jimmyyhwu/tidybot2-resources/README.md

# tidybot2-resources

This repository hosts resources for the TidyBot++ open-source robot. Please see the following links for more information:

* Project page: https://tidybot2.github.io
* Assembly guide: https://tidybot2.github.io/docs
* Code: https://github.com/jimmyyhwu/tidybot2
