jimmyyhwu/tidybot2-resources/Machining/Intermediate Shaft - Specifications.pdf

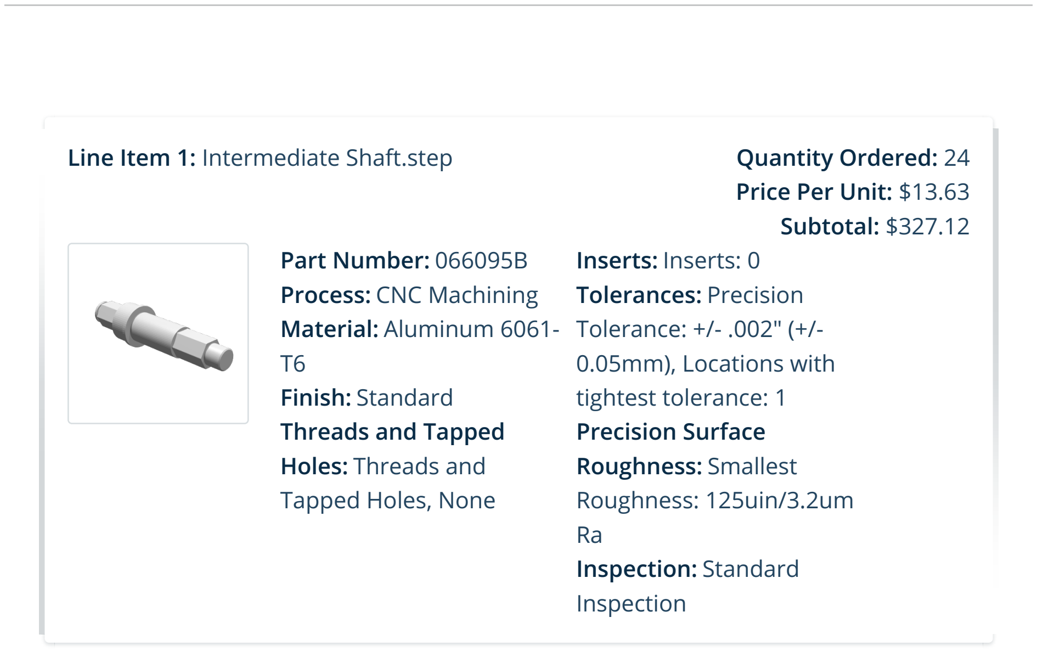
[picture p1: page 1]

Line Item 1: Intermediate Shaft.step | Quantity Ordered: 24 Price Per Unit: $13.63 Subtotal: $327.12
Part Number: 066095B Process: CNC Machining Material: Aluminum 6061- T6 Finish: Standard Threads and Tapped Holes: Threads and Tapped Holes, None | Inserts: Inserts: 0 Tolerances: Precision Tolerance: +/- .002" (+/- 0.05mm), Locations with tightest tolerance: 1 Precision Surface Roughness: Smallest Roughness: 125uin/3.2um

Ra
| Inspection: Standard
Inspection
