jimmyyhwu/tidybot2-resources/3D Printing/ARX5/ARX5 Wrist Camera Mount Bottom.stl

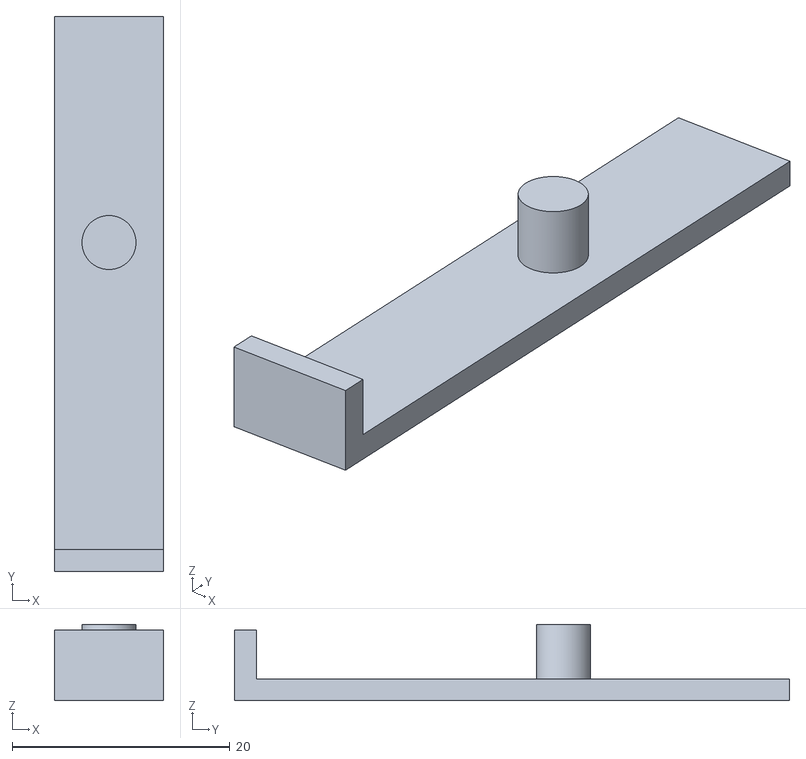
[picture p2: CAD file, 2024-12-10]
3D Printing/ARX5/ARX5 Wrist Camera Mount Bottom.stl
10.0 x 51.0 x 7.00
