jimmyyhwu/tidybot2-resources/3D Printing/Caster Module Alignment Jig.stl

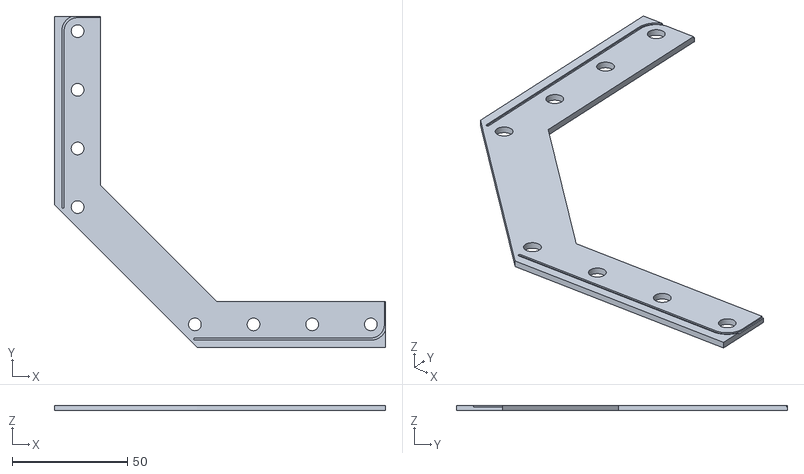
[picture p3: CAD file, 2024-12-10]
3D Printing/Caster Module Alignment Jig.stl
143.3 x 143.3 x 2.00
