jimmyyhwu/tidybot2-resources/3D Printing/Caster Module/Bambu Lab X1-Carbon/Wheel Mount B.3mf

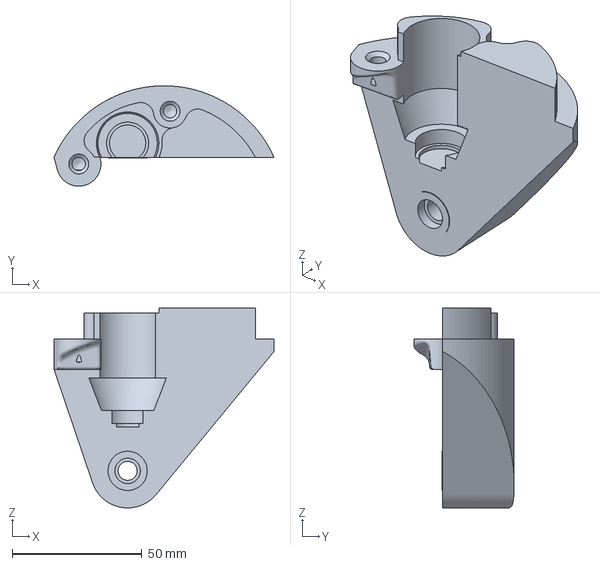
[picture p4: CAD file, 2024-12-10]
3D Printing/Caster Module/Bambu Lab X1-Carbon/Wheel Mount B.3mf
84.8 x 38.6 x 77.0 mm
