jimmyyhwu/tidybot2-resources/3D Printing/Caster Module/Bambu Lab X1E/Wheel Mount A.3mf

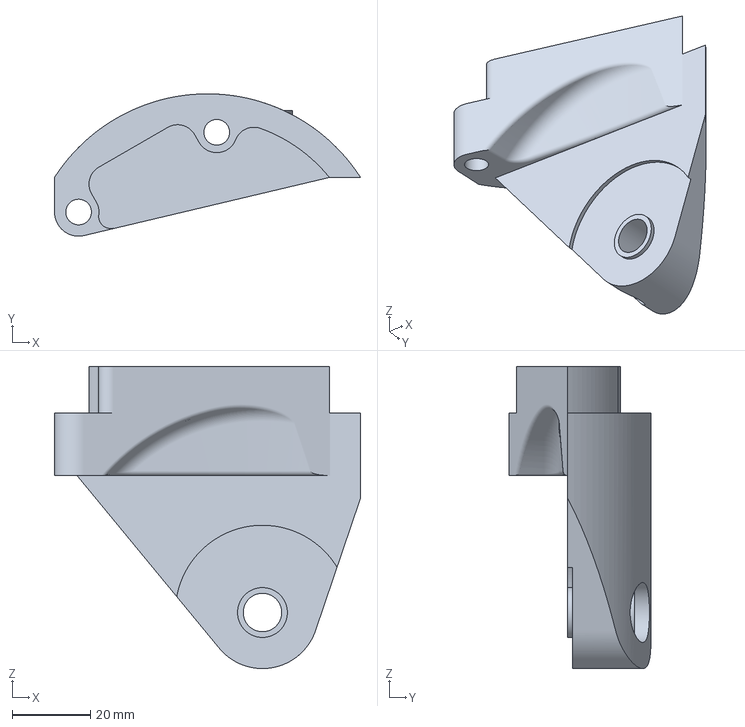
[picture p5: CAD file, 2024-12-10]
3D Printing/Caster Module/Bambu Lab X1E/Wheel Mount A.3mf
78.0 x 36.3 x 77.0 mm
