jimmyyhwu/tidybot2-resources/3D Printing/Franka/Franka Battery Mount Right.stl

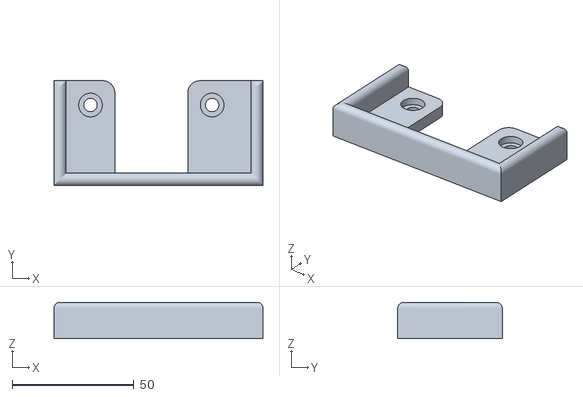
[picture p6: CAD file, 2024-12-10]
3D Printing/Franka/Franka Battery Mount Right.stl
85.9 x 43.0 x 15.0
