jimmyyhwu/tidybot2-resources/3D Printing/Kinova/Kinova Base Camera Mount Top.stl

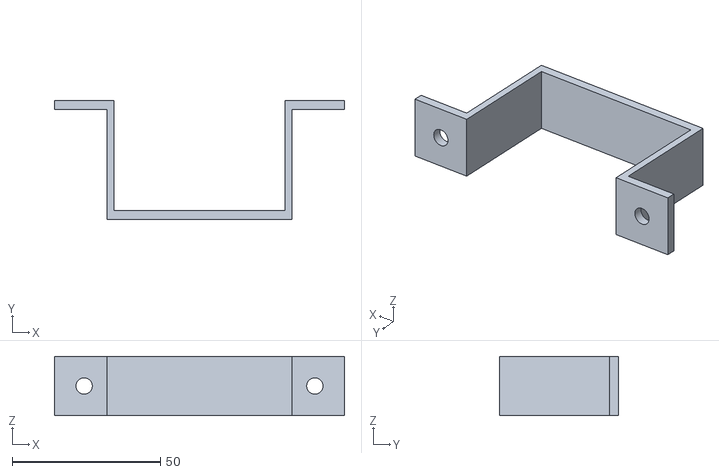
[picture p7: CAD file, 2024-12-10]
3D Printing/Kinova/Kinova Base Camera Mount Top.stl
97.8 x 40.0 x 20.0
