jimmyyhwu/tidybot2-resources/Laser Cutting/Kinova Bottom Plate.dxf

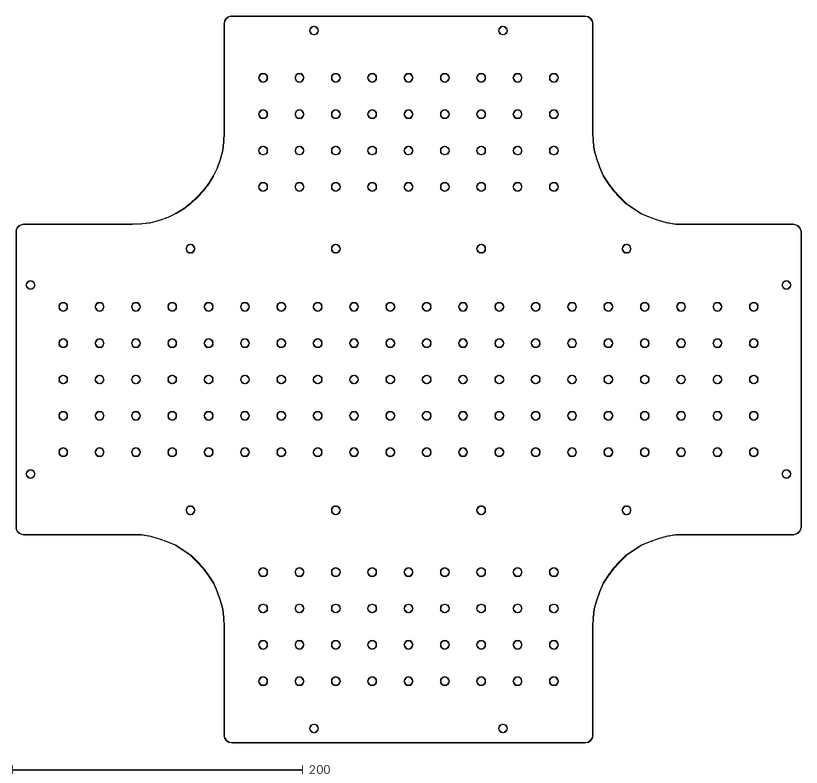
[picture p8: CAD file, 2024-12-10]
Laser Cutting/Kinova Bottom Plate.dxf
540.0 x 500.0
