jimmyyhwu/tidybot2-resources/STEP/Caster Module/Imports/WCP-1464.step

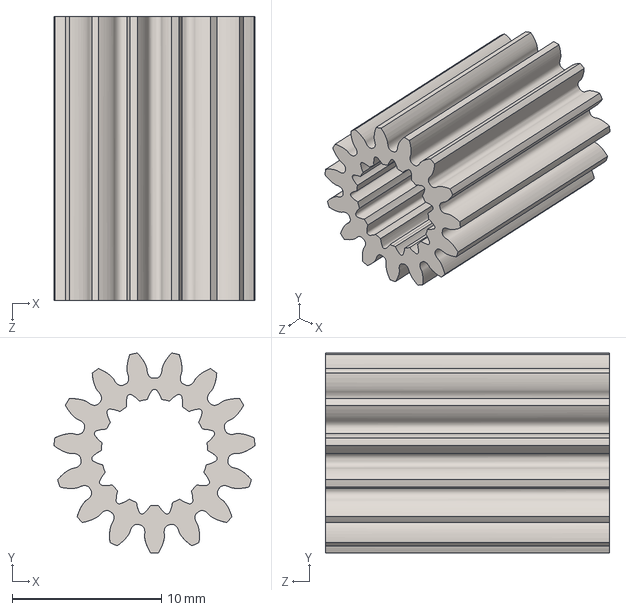
[picture p9: CAD file, 2024-12-10]
STEP/Caster Module/Imports/WCP-1464.step
13.5 x 13.4 x 19.1 mm
