jimmyyhwu/tidybot2-resources/STEP/Caster Module/Intermediate Shaft.step

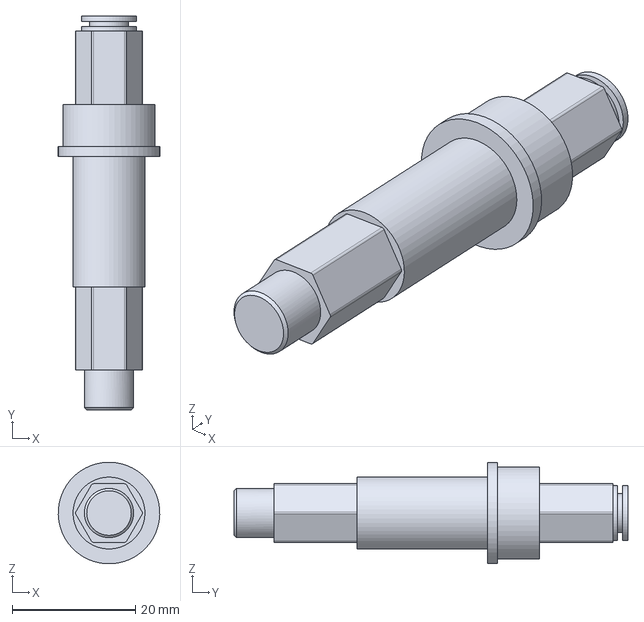
[picture p10: CAD file, 2024-12-10]
STEP/Caster Module/Intermediate Shaft.step
16.5 x 64.0 x 16.5 mm
