jimmyyhwu/tidybot2-resources/STEP/Mobile Base - ARX5.step

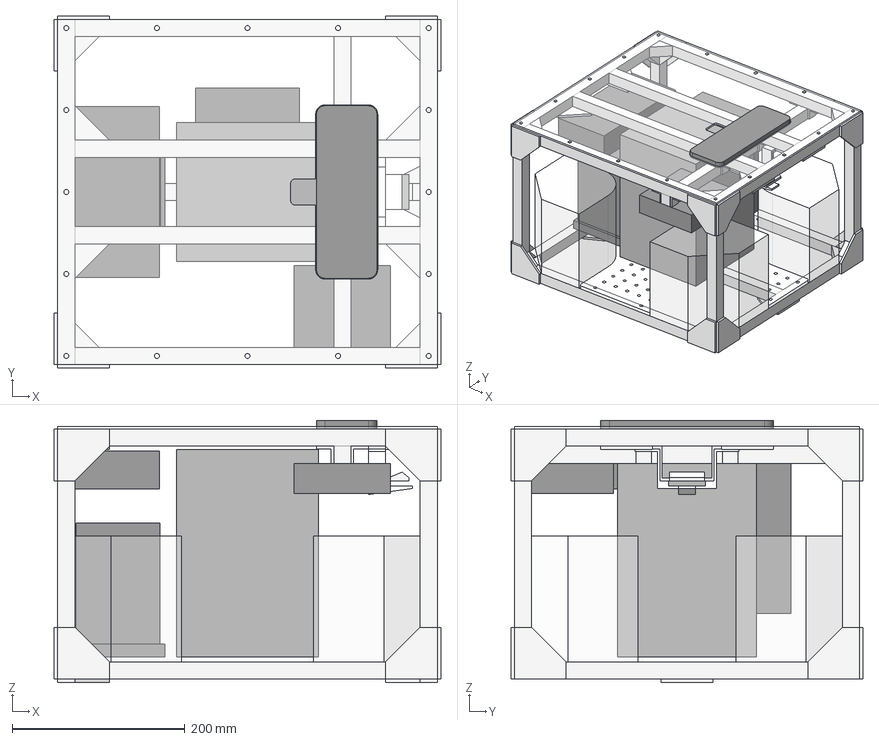
[picture p11: CAD file, 2024-12-10]
STEP/Mobile Base - ARX5.step
448.0 x 408.0 x 304.0 mm
2020 28mm Gusset x 16
ARX5 Bottom Plate
ARX5 Battery Mount
2020 20mm Corner Bracket x 8
Intel NUC7i5BNK
ARX5 Base Camera Mount Bottom
2020 90 Degree Plate x 20
2020 Tee Plate x 2
2020 250mm Rail x 4
2020 400mm Rail x 12
2020 20mm Gusset x 8
ARX5 Power Adapter
ARX5 Mounting Plate
Caster Module x 4
ARX5 Base Camera Mount Top
Duracell Ultra DURDC12-14NB Battery
Power Distribution Panel
Base Camera Mount Shim
ARX5 Top Plate
Anker SOLIX C300 Portable Power Station
