jimmyyhwu/tidybot2-resources/3D Printing/ARX5/ARX5 Base Camera Mount Bottom.stl

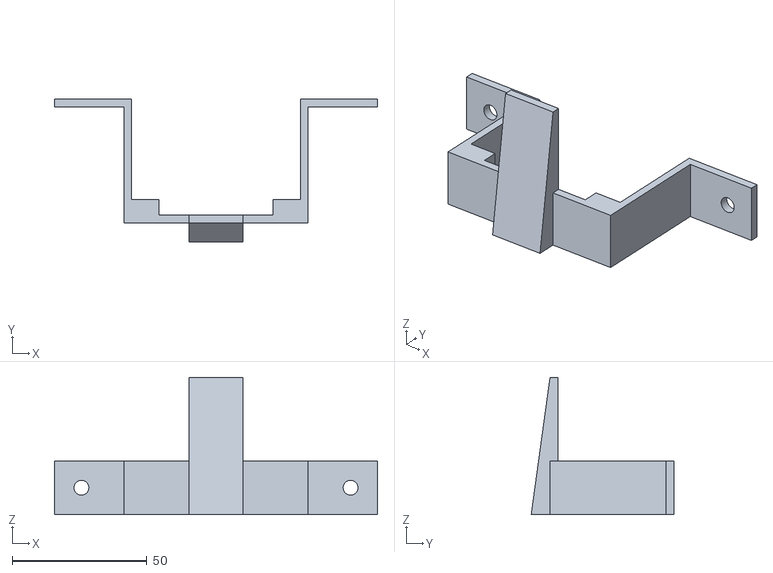
[picture p12: CAD file, 2024-12-10]
3D Printing/ARX5/ARX5 Base Camera Mount Bottom.stl
120.0 x 53.0 x 51.0
