jimmyyhwu/tidybot2-resources/3D Printing/Battery Flag.stl

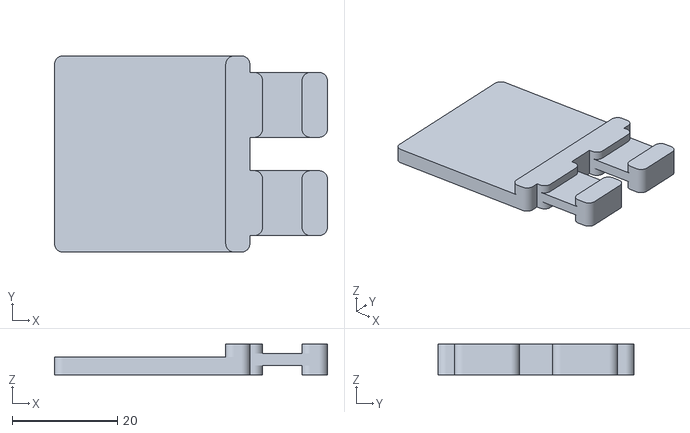
[picture p13: CAD file, 2024-12-10]
3D Printing/Battery Flag.stl
52.0 x 37.3 x 5.90
