jimmyyhwu/tidybot2-resources/3D Printing/Franka/Franka Base Camera Mount Bottom.stl

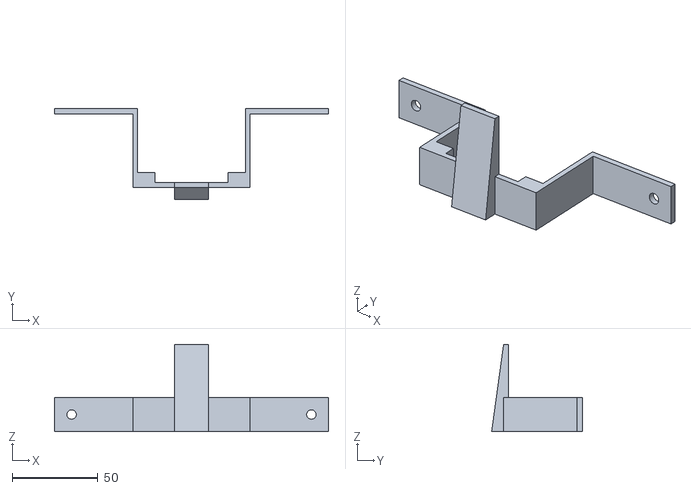
[picture p14: CAD file, 2024-12-10]
3D Printing/Franka/Franka Base Camera Mount Bottom.stl
160.0 x 53.0 x 51.0
