jimmyyhwu/tidybot2-resources/3D Printing/Kinova/Kinova Base Camera Mount Bottom.stl

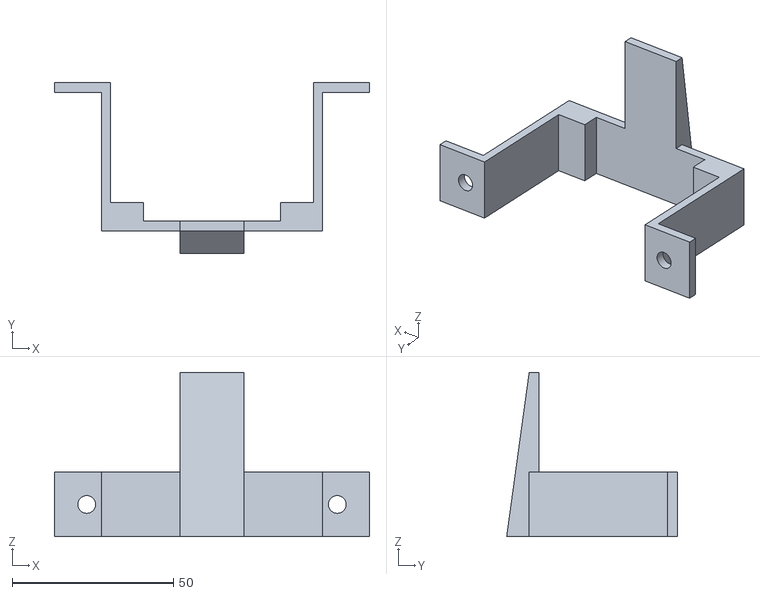
[picture p15: CAD file, 2024-12-10]
3D Printing/Kinova/Kinova Base Camera Mount Bottom.stl
97.8 x 53.0 x 51.0
