jimmyyhwu/tidybot2-resources/Laser Cutting/Franka Bottom Plate Back.dxf

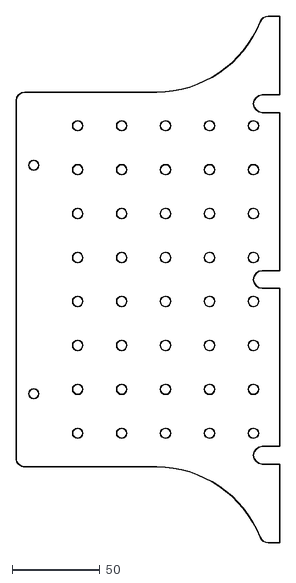
[picture p16: CAD file, 2024-12-10]
Laser Cutting/Franka Bottom Plate Back.dxf
150.0 x 299.6
