jimmyyhwu/tidybot2-resources/STEP/Caster Module/Imports/Kraken X60 Motor Riser.step

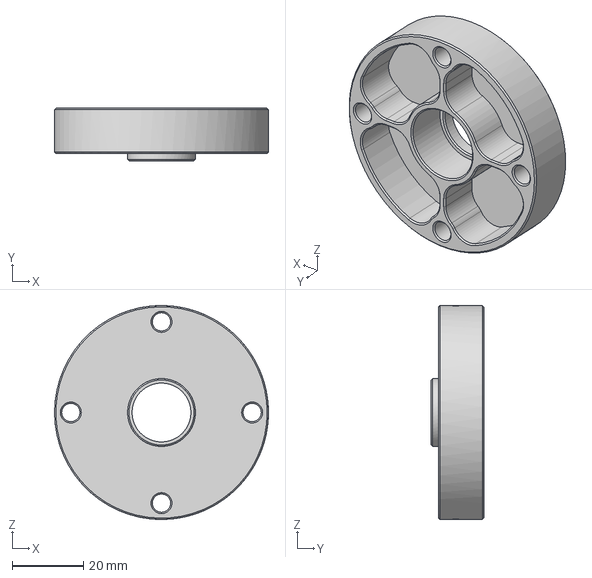
[picture p17: CAD file, 2024-12-10]
STEP/Caster Module/Imports/Kraken X60 Motor Riser.step
59.9 x 14.7 x 59.9 mm
