jimmyyhwu/tidybot2-resources/STEP/Logitech Wrist Camera Mount Bottom.step

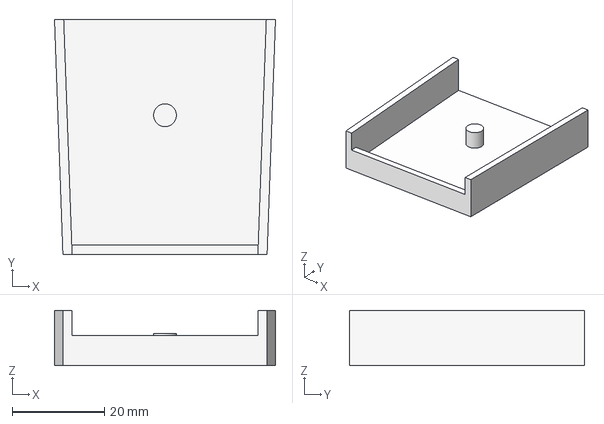
[picture p18: CAD file, 2024-12-10]
STEP/Logitech Wrist Camera Mount Bottom.step
48.0 x 51.0 x 12.0 mm
