jimmyyhwu/tidybot2-resources/3D Printing/ARX5/ARX5 Wrist Camera Mount Top.stl

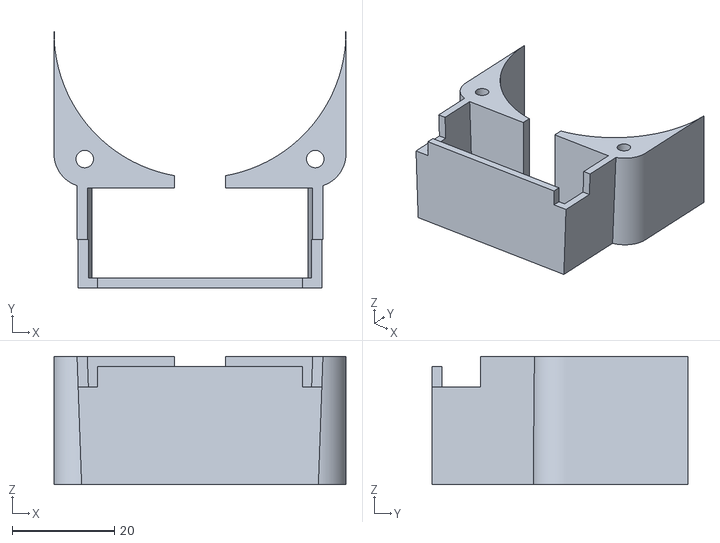
[picture p19: CAD file, 2024-12-10]
3D Printing/ARX5/ARX5 Wrist Camera Mount Top.stl
57.0 x 50.0 x 25.0
