jimmyyhwu/tidybot2-resources/3D Printing/Base Camera Mount Shim.stl

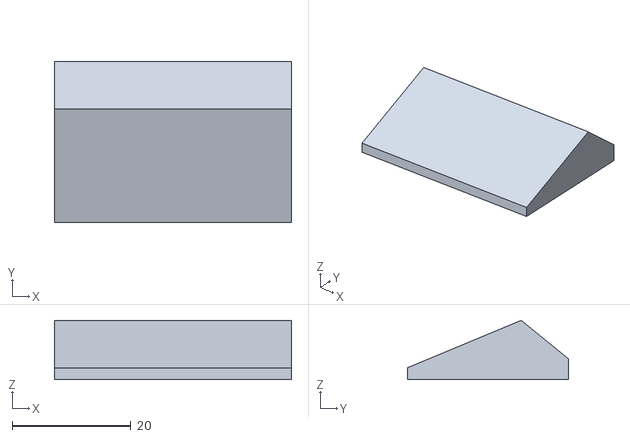
[picture p20: CAD file, 2024-12-10]
3D Printing/Base Camera Mount Shim.stl
40.0 x 27.2 x 10.0
