jimmyyhwu/tidybot2-resources/3D Printing/Franka/Franka Bottom Plate Support Bracket.stl

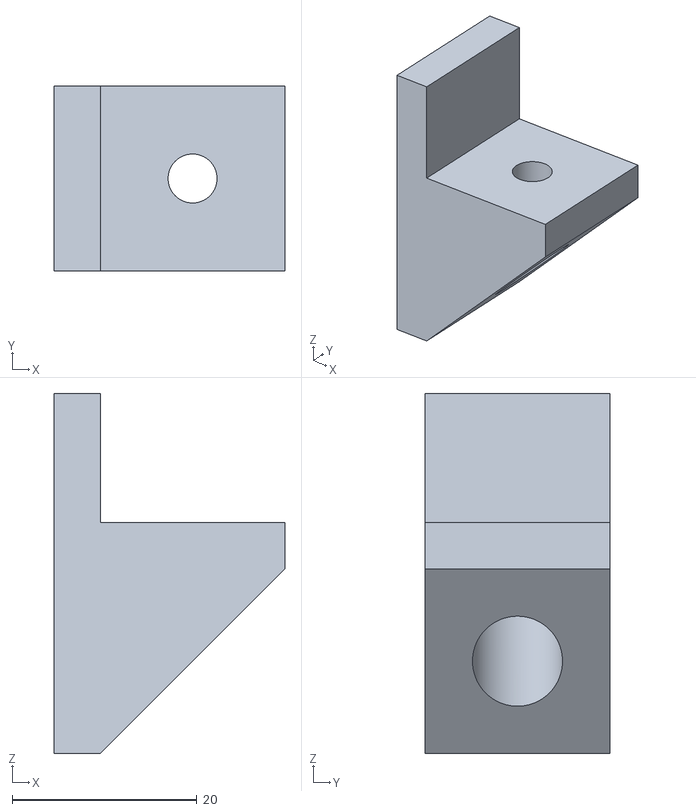
[picture p21: CAD file, 2024-12-10]
3D Printing/Franka/Franka Bottom Plate Support Bracket.stl
25.0 x 20.0 x 39.0
