jimmyyhwu/tidybot2-resources/Laser Cutting/Kinova Top Plate Right.dxf

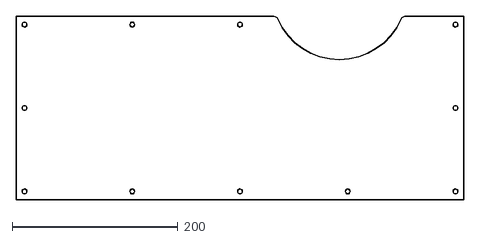
[picture p22: CAD file, 2024-12-10]
Laser Cutting/Kinova Top Plate Right.dxf
540.0 x 221.1
