jimmyyhwu/tidybot2-resources/STEP/Caster Module/Imports/SDS Colson Wheel Kit.STEP

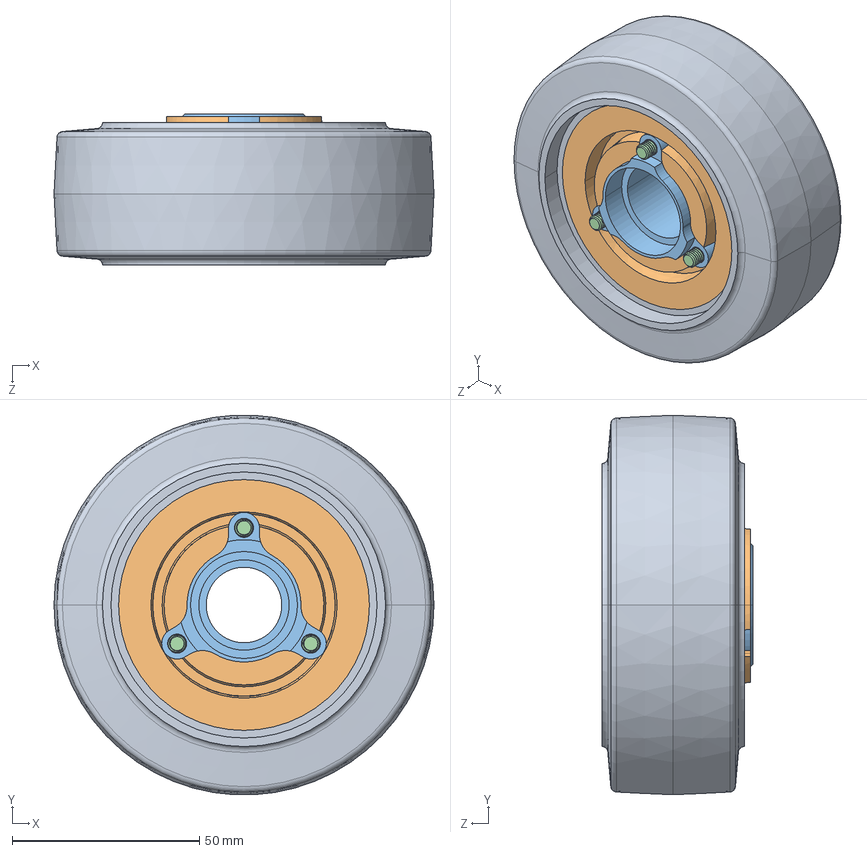
[picture p23: CAD file, 2024-12-10]
STEP/Caster Module/Imports/SDS Colson Wheel Kit.STEP
101.6 x 101.5 x 40.4 mm
Colson Performa 4 X 1.5
MK4 Colson Hub 4 X 1.5
Screw, 10-32 X 1, 91251A347_91251A347 x 3
