jimmyyhwu/tidybot2-resources/3D Printing/ARX5/ARX5 Battery Mount.stl

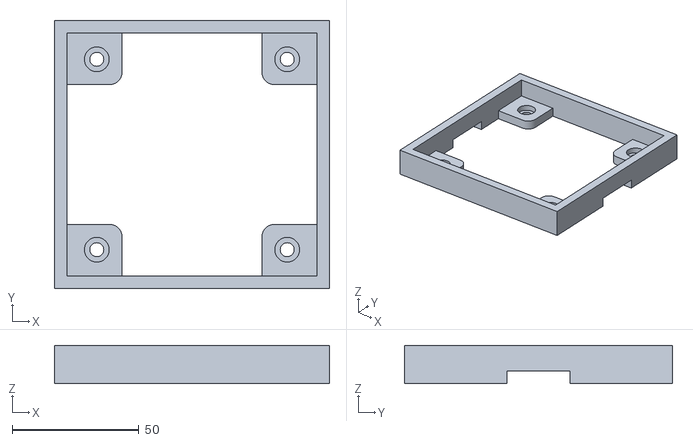
[picture p25: CAD file, 2024-12-10]
3D Printing/ARX5/ARX5 Battery Mount.stl
108.3 x 105.7 x 15.0
