jimmyyhwu/tidybot2-resources/3D Printing/Franka/Franka Wrist Camera Mount.stl

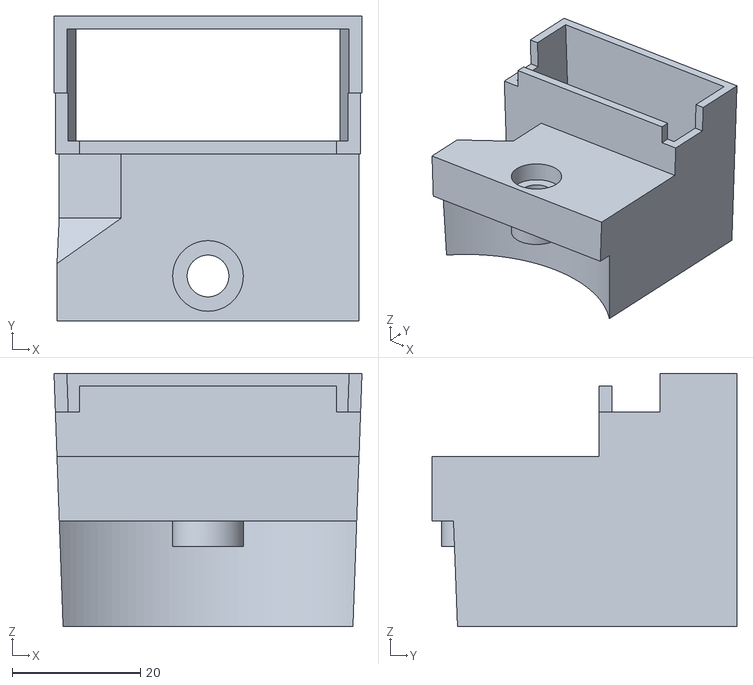
[picture p26: CAD file, 2024-12-10]
3D Printing/Franka/Franka Wrist Camera Mount.stl
48.0 x 47.5 x 39.5
