jimmyyhwu/tidybot2-resources/3D Printing/Kinova/Kinova Mounting Plate Alignment Jig.stl

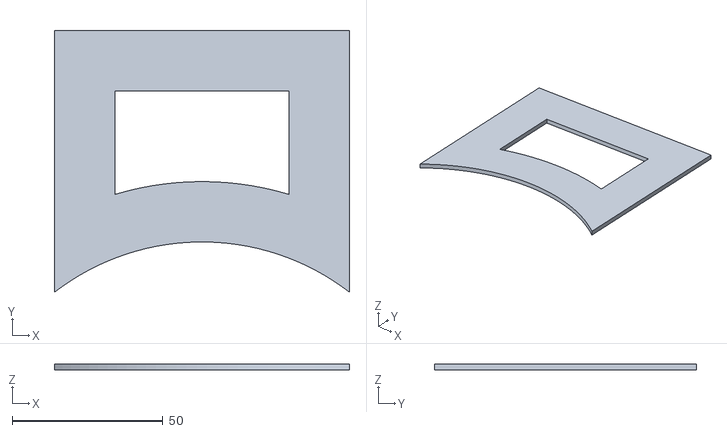
[picture p27: CAD file, 2024-12-10]
3D Printing/Kinova/Kinova Mounting Plate Alignment Jig.stl
97.8 x 86.7 x 2.00
