jimmyyhwu/tidybot2-resources/3D Printing/Wheel Alignment Jig.stl

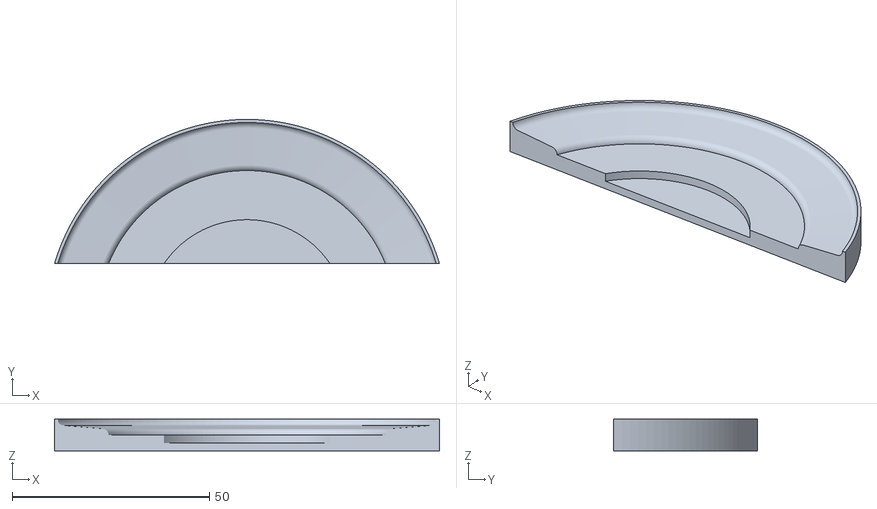
[picture p28: CAD file, 2024-12-10]
3D Printing/Wheel Alignment Jig.stl
97.5 x 36.5 x 8.00
