jimmyyhwu/tidybot2-resources/Laser Cutting/Kinova Top Plate Left.dxf

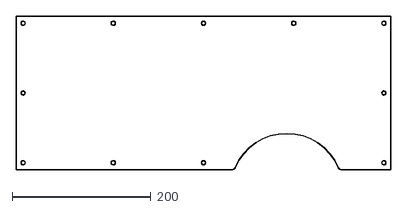
[picture p29: CAD file, 2024-12-10]
Laser Cutting/Kinova Top Plate Left.dxf
540.0 x 221.1
