jimmyyhwu/tidybot2-resources/STEP/Caster Module/Imports/WCP-1013.step

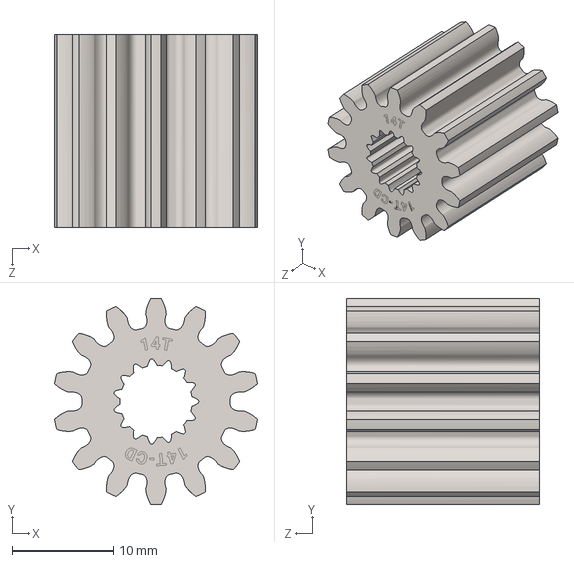
[picture p30: CAD file, 2024-12-10]
STEP/Caster Module/Imports/WCP-1013.step
20.0 x 20.3 x 19.1 mm
