jimmyyhwu/tidybot2-resources/STEP/Logitech Wrist Camera Mount Top.step

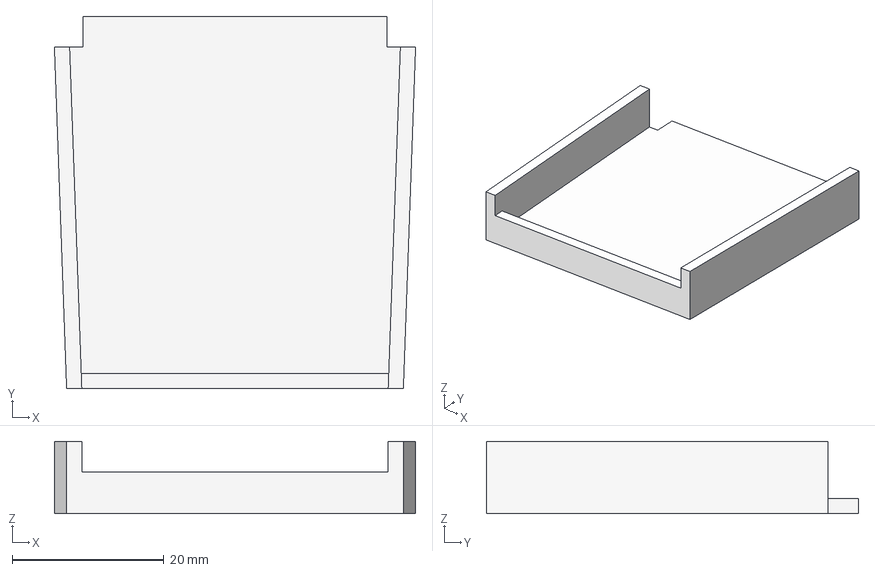
[picture p31: CAD file, 2024-12-10]
STEP/Logitech Wrist Camera Mount Top.step
47.6 x 49.0 x 9.50 mm
