jimmyyhwu/tidybot2-resources/3D Printing/ARX5/ARX5 Riser.stl

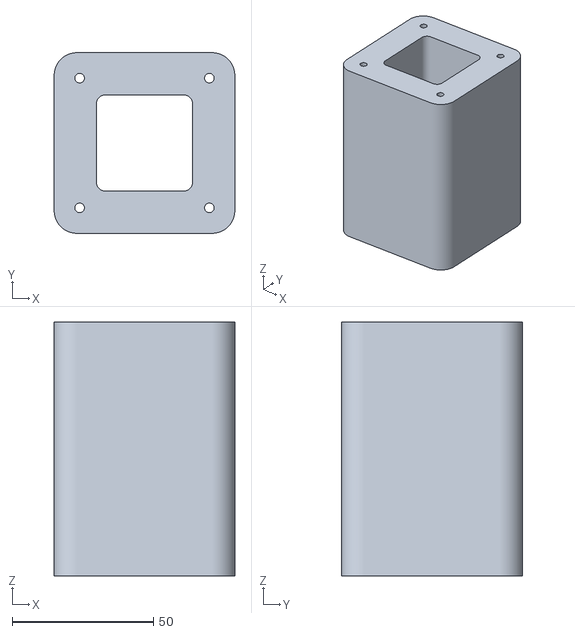
[picture p32: CAD file, 2024-12-10]
3D Printing/ARX5/ARX5 Riser.stl
64.0 x 64.0 x 90.0
