jimmyyhwu/tidybot2-resources/3D Printing/Breaker Terminal Spacer.stl

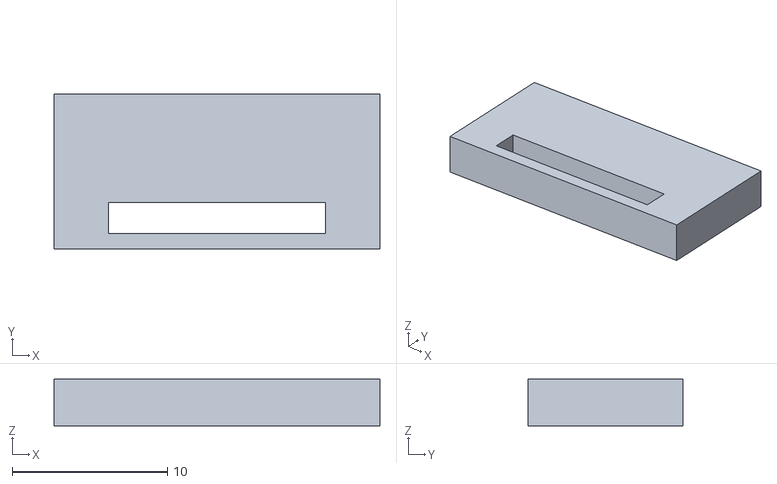
[picture p33: CAD file, 2024-12-10]
3D Printing/Breaker Terminal Spacer.stl
21.0 x 10.0 x 3.00
