jimmyyhwu/tidybot2-resources/3D Printing/Franka/Franka Base Camera Mount Top.stl

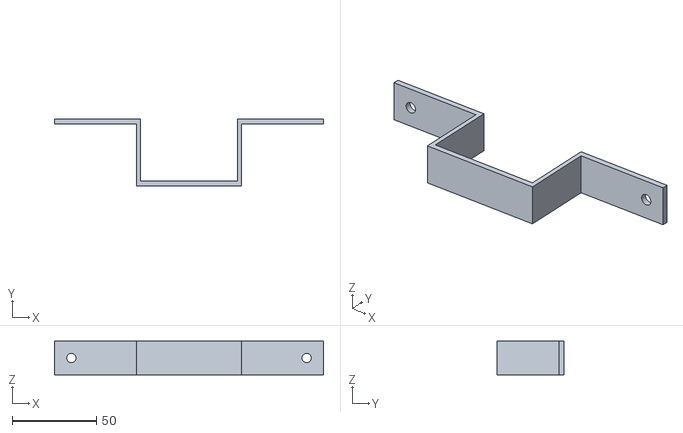
[picture p34: CAD file, 2024-12-10]
3D Printing/Franka/Franka Base Camera Mount Top.stl
160.0 x 40.0 x 20.0
