jimmyyhwu/tidybot2-resources/3D Printing/Kinova/Kinova Battery Mount Right.stl

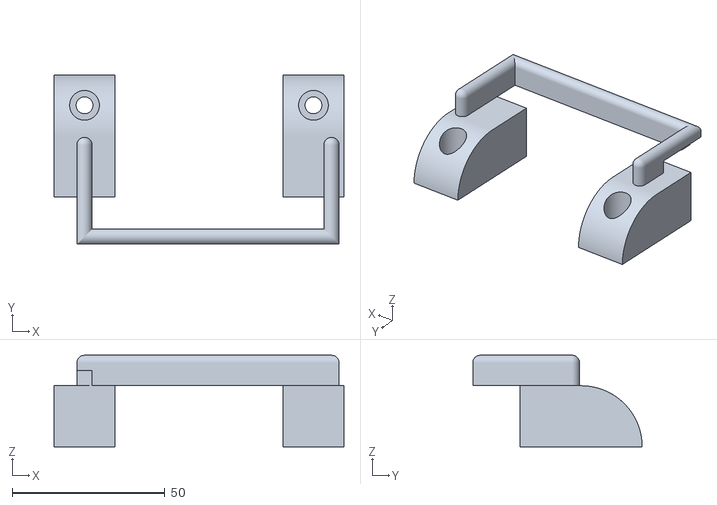
[picture p35: CAD file, 2024-12-10]
3D Printing/Kinova/Kinova Battery Mount Right.stl
95.0 x 55.5 x 30.0
