jimmyyhwu/tidybot2-resources/Laser Cutting/ARX5 Bottom Plate.dxf

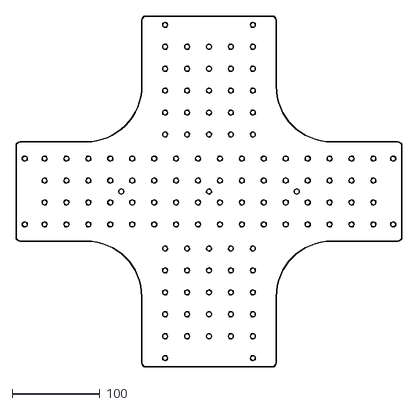
[picture p36: CAD file, 2024-12-10]
Laser Cutting/ARX5 Bottom Plate.dxf
440.0 x 400.0
