jimmyyhwu/tidybot2-resources/3D Printing/ARX5/ARX5 Base Camera Mount Top.stl

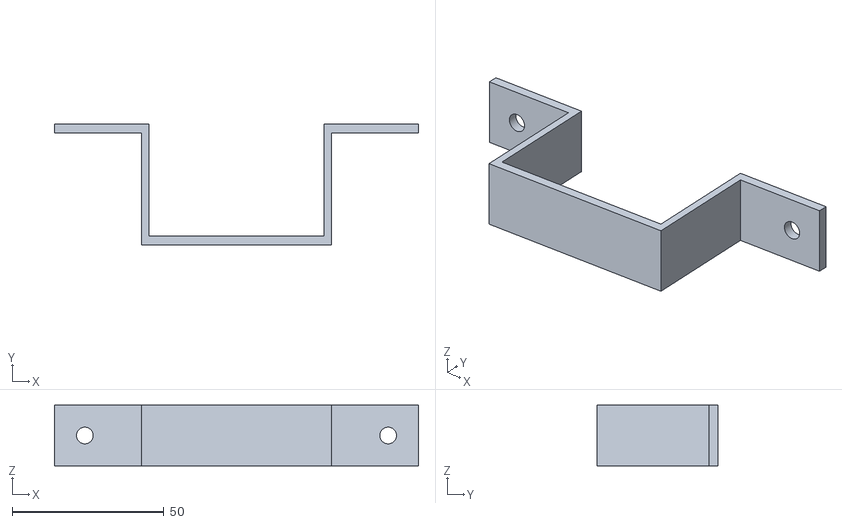
[picture p38: CAD file, 2024-12-10]
3D Printing/ARX5/ARX5 Base Camera Mount Top.stl
120.0 x 40.0 x 20.0
