jimmyyhwu/tidybot2-resources/3D Printing/Kinova/Kinova Fisheye Mount.stl

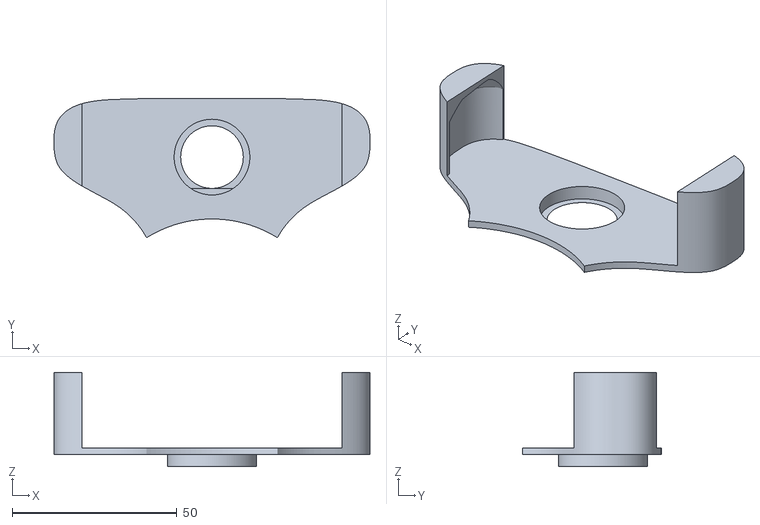
[picture p39: CAD file, 2024-12-10]
3D Printing/Kinova/Kinova Fisheye Mount.stl
96.0 x 42.4 x 28.6
