jimmyyhwu/tidybot2-resources/3D Printing/Logitech Fisheye Mount.stl

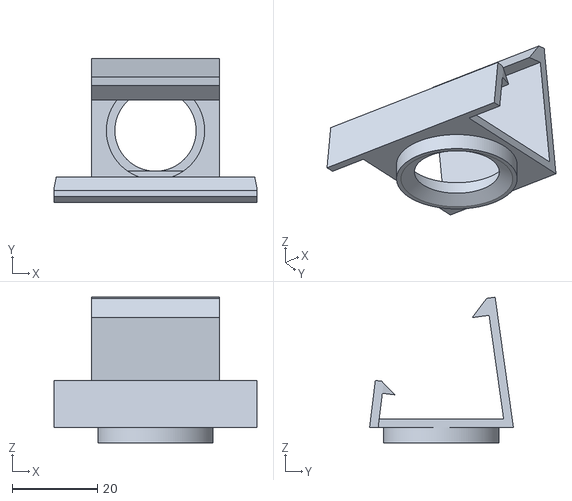
[picture p40: CAD file, 2024-12-10]
3D Printing/Logitech Fisheye Mount.stl
47.5 x 33.7 x 34.1
