jimmyyhwu/tidybot2-resources/Laser Cutting/Kinova Bottom Plate Back.dxf

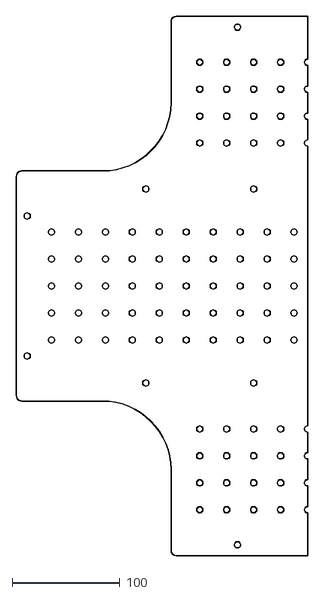
[picture p41: CAD file, 2024-12-10]
Laser Cutting/Kinova Bottom Plate Back.dxf
270.0 x 500.0
