jimmyyhwu/tidybot2-resources/STEP/Fisheye Mount.step

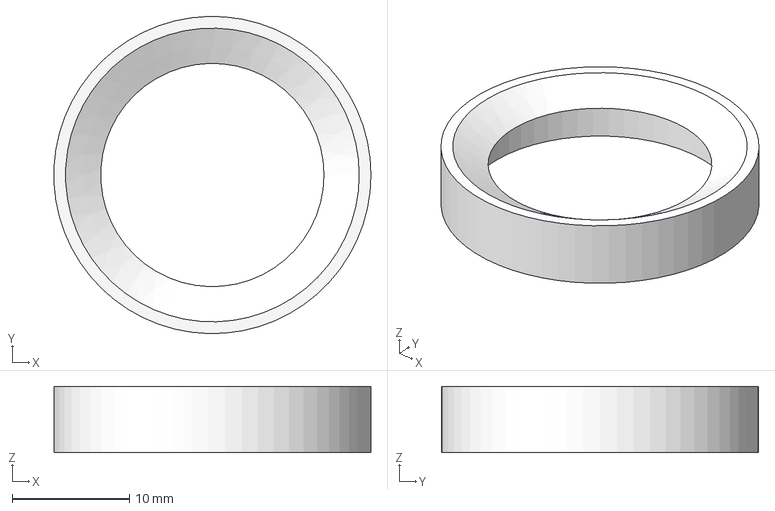
[picture p42: CAD file, 2024-12-10]
STEP/Fisheye Mount.step
27.0 x 27.0 x 5.63 mm
