jimmyyhwu/tidybot2-resources/Laser Cutting/Franka Bottom Plate Front (EcoFlow DELTA 2 Max).dxf

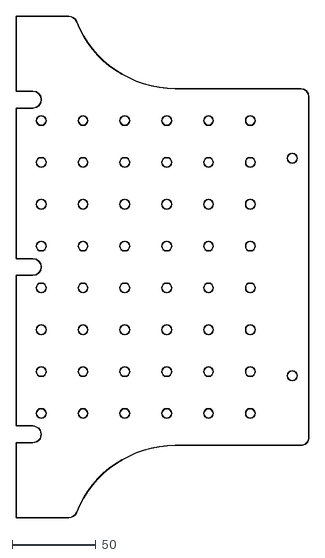
[picture p43: CAD file, 2024-12-10]
Laser Cutting/Franka Bottom Plate Front (EcoFlow DELTA 2 Max).dxf
175.0 x 299.6
