jimmyyhwu/tidybot2-resources/Laser Cutting/Franka Top Plate Front.dxf

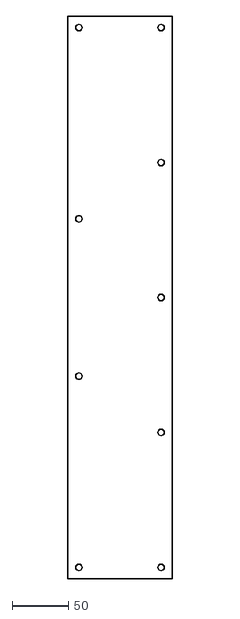
[picture p45: CAD file, 2024-12-10]
Laser Cutting/Franka Top Plate Front.dxf
93.0 x 500.0
