jimmyyhwu/tidybot2-resources/Laser Cutting/Kinova Bottom Plate Front.dxf

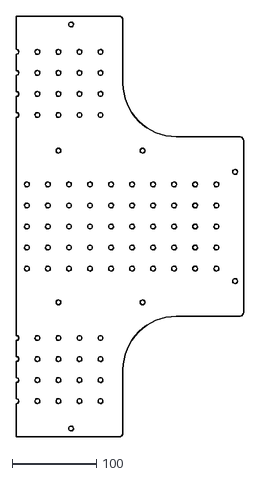
[picture p46: CAD file, 2024-12-10]
Laser Cutting/Kinova Bottom Plate Front.dxf
270.0 x 500.0
