jimmyyhwu/tidybot2-resources/Laser Cutting/ARX5 Top Plate.dxf

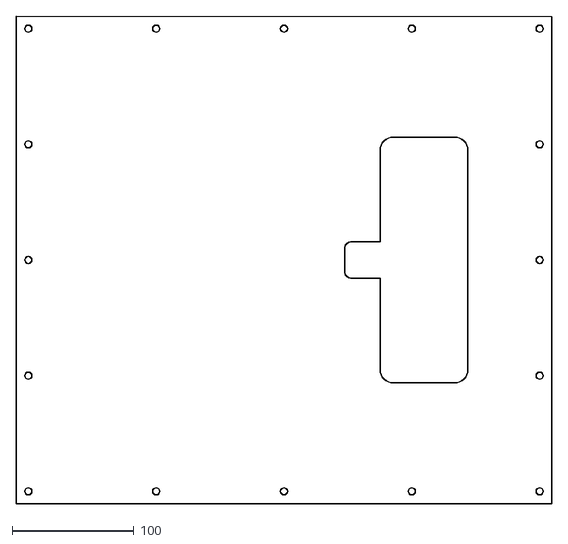
[picture p47: CAD file, 2024-12-10]
Laser Cutting/ARX5 Top Plate.dxf
440.0 x 400.0
