jimmyyhwu/tidybot2-resources/Laser Cutting/Franka Bottom Plate Front.dxf

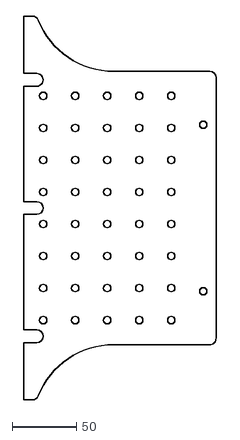
[picture p48: CAD file, 2024-12-10]
Laser Cutting/Franka Bottom Plate Front.dxf
150.0 x 299.6
