jimmyyhwu/tidybot2-resources/Laser Cutting/Franka Top Plate Center.dxf

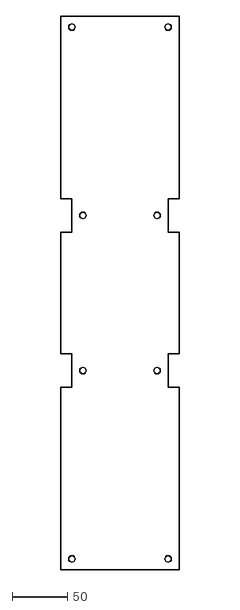
[picture p49: CAD file, 2024-12-10]
Laser Cutting/Franka Top Plate Center.dxf
107.0 x 500.0
