jimmyyhwu/tidybot2-resources/(list of files, cad)

Other CAD files:
3D Printing/Caster Module/Original Prusa MK3.5/Wheel Mount A.3mf
3D Printing/Caster Module/Original Prusa MK3.9/Wheel Mount B.3mf
3D Printing/Caster Module/Bambu Lab X1-Carbon/Wheel Mount A.3mf
3D Printing/Caster Module/Bambu Lab X1E/Wheel Mount B.3mf
3D Printing/Caster Module/Original Prusa MK3.5/Wheel Mount B.3mf
3D Printing/Caster Module/Original Prusa MK3.9/Wheel Mount A.3mf
STEP/Caster Module/Wheel Mount B.step
STEP/Caster Module/Wheel Mount A.step
3D Printing/Franka/Franka Battery Mount Left.stl
3D Printing/Kinova/Kinova Battery Mount Left.stl
3D Printing/Caster Module/Wheel Mount A.stl
3D Printing/Caster Module/Wheel Mount B.stl
3D Printing/Franka/Franka T-Nut Alignment Jig.stl
3D Printing/Kinova/Kinova T-Nut Alignment Jig.stl
