jimmyyhwu/tidybot2-resources/Machining/Intermediate Shaft - 2D Drawing.pdf

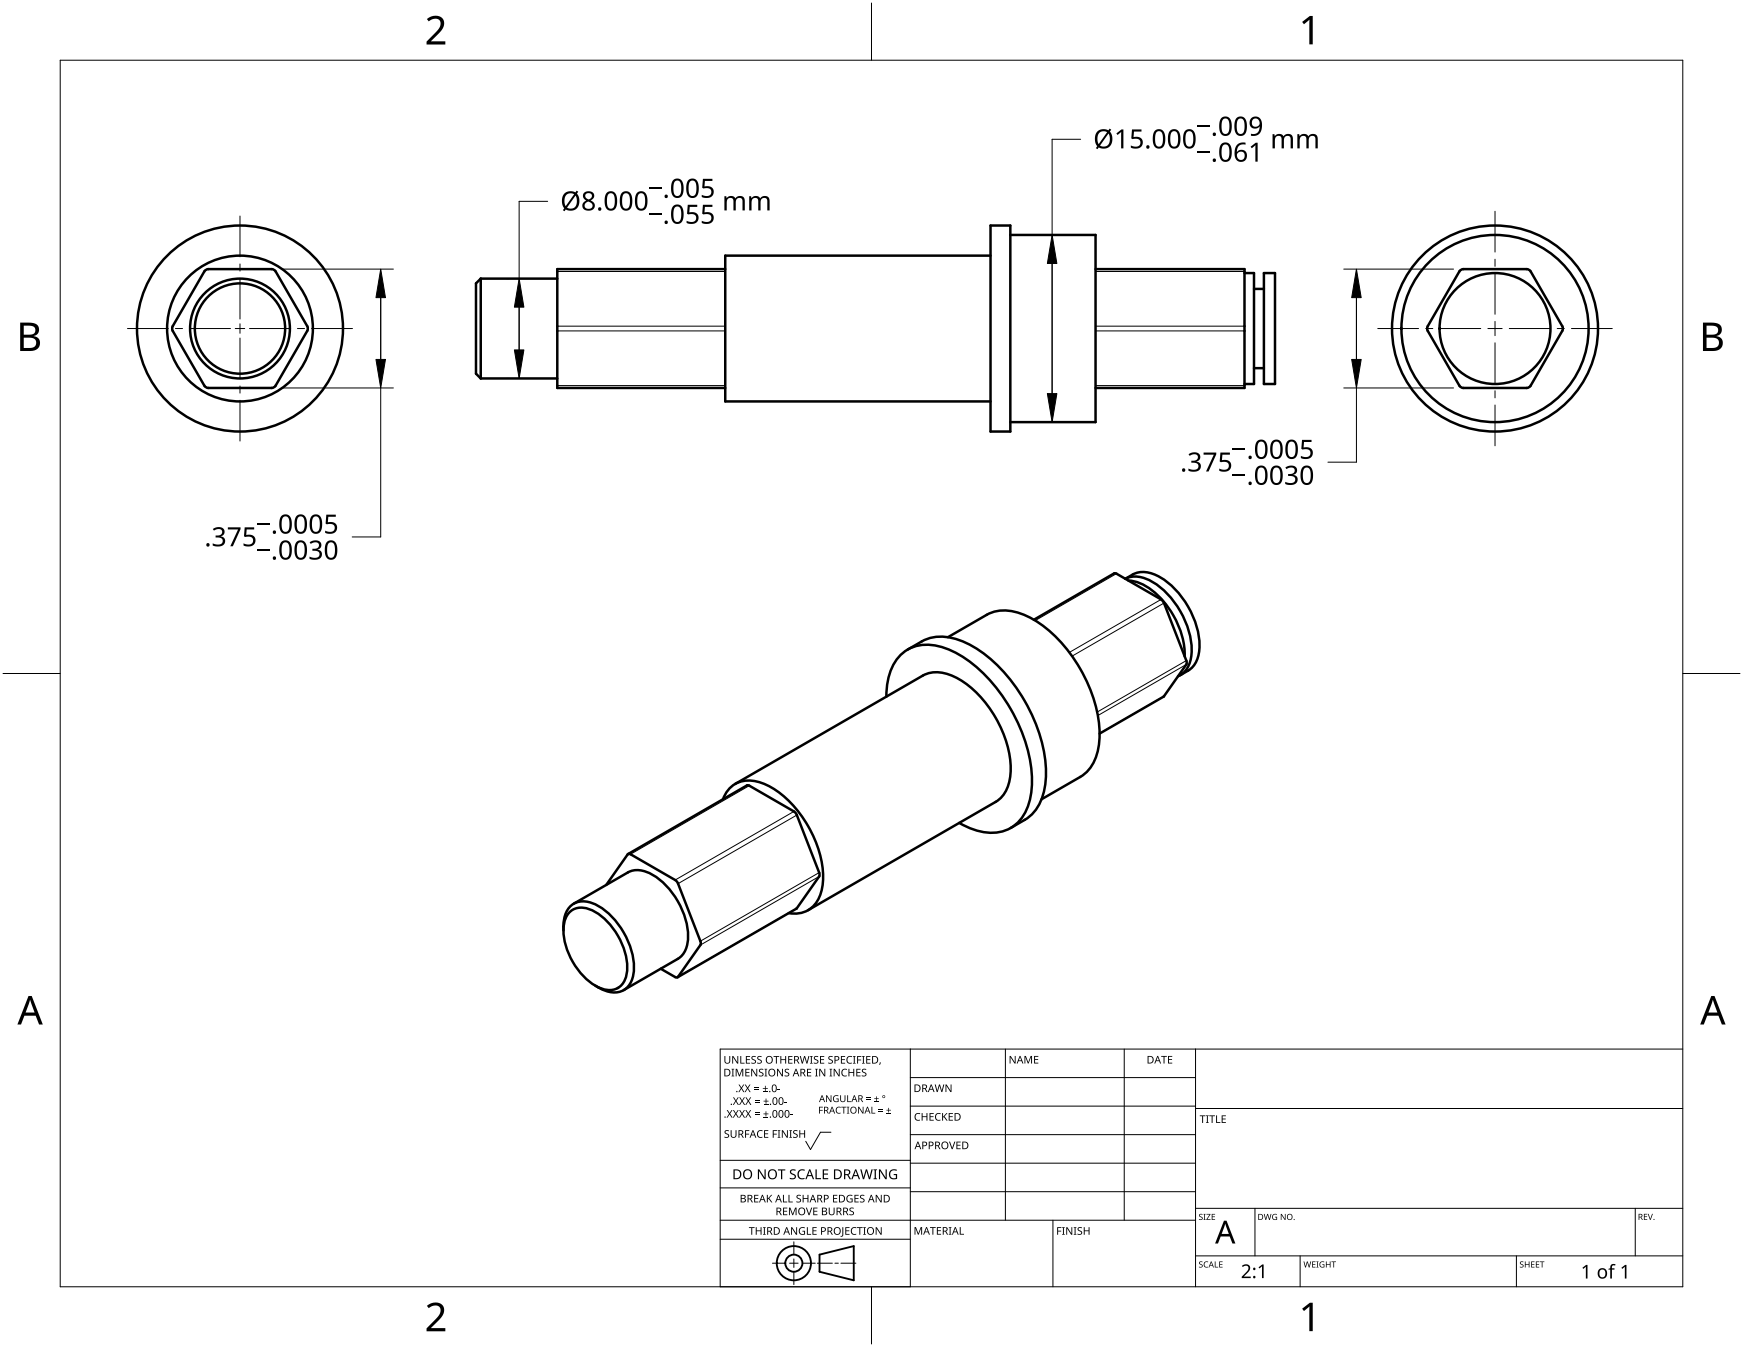
[picture p92: page 1]
